LeonDV/SENA_monitoreo_fermentacion_cacao/README.md

# Termómetro de 3 sondas LoRa
Código para sensor de monitoreo del proceso de fermentación de cacao.
SENA AGROTURISTICO - SOCORRO

El repositorio incluye todos los archivos requeridos para la fabricación de un termómetro LoRa de 3 sondas con dos salidas de alarma. Los archivos para fabricación son los siguientes:

- Archivo de fabricación de circuito: 
  - **SENA_monitoreo_fermentacion_cacao/circuito/gerber/Gerber_PCB_SENA- TERMOMETRO_3_SONDAS_LORA.zip**
- Lista de materiales:
  - **SENA_monitoreo_fermentacion_cacao/circuito/lista_materiales/lista_materiales_ensamble.csv**
- Programación de Atmega328: 
  - **SENA_monitoreo_fermentacion_cacao/firmware_atmega_328/binarios_programacion_atmega/termometro_3_sondas_cacao.ino.eightanaloginputs.hex**
