LeonDV/SENA_monitoreo_fermentacion_cacao/circuito/lista_materiales/lista_materiales_ensamble.csv

ID | Name | Designator | Footprint | Quantity | Manufacturer Part | Manufacturer
1 | 100uF | C2,C1 | CAP-TH_BD5.0-P2.00-D0.8-FD | 2 | TY1071AMC115RB | Xunda
2 | SwitchSMD_daimob | OFF | SWITCHSMD | 1
3 | TS-1092D-B3D2 | RST | KEY-TH_2P-L6.0-W3.9-P6.50 | 1 | TS-1092D-B3D2 | Yuandi
4 | 10k | R7 | R_AXIAL-0.4 | 1
5 | HDR-F-2.54_1x4 | H1 | HDR-F-2.54_1X4 | 1
6 | WJ128V-5.0-2P | 5V5,ALARMA1,ALARMA2,BAT | CONN-TH_2P-P5.00_WJ128V-5.0-2P | 4 | WJ128V-5.0-2P | ReliaPro
7 | 22pF | C5,C6 | CAP-TH_L5.0-W2.5-P2.54-D0.7 | 2 | CC1H220JA1FDCH4B10MF | Dersonic
8 | HDR-M-2.54_1x3 | J2 | HDR-M-2.54_1X3 | 1
9 | AO3401A_C700954 | Q1,Q2,Q3 | SOT-23-3_L2.9-W1.3-P1.90-LS2.4-BR | 3 | AO3401A | HUASHUO(华朔)
10 | 100k | R1,R4,R5 | R_AXIAL-0.4 | 3
11 | 1k | R2,R3,R10,R11 | R_AXIAL-0.4 | 4
12 | 4.7k | R6,R8,R9 | R_AXIAL-0.4 | 3
13 | 1909763-1 | RF2 | ANT-SMD_1909763-1 | 1 | 1909763-1 | TE Connectivity
14 | EK508V-03P | SENS-1,SENS-2,SENS-3 | CONN-TH_EK508V-03P | 3 | EK508V-03P | Dinkle
15 | SX1276S8S+T-X1 | U1 | WIRELM-SMD_SX1278S165SY-T-X1 | 1 | SX1276S8S+T-X1 | Vollgo
16 | daimob-TP4056-modulo | U2 | DAIMOB-TP4056-MODULE-F | 1
17 | ATMEGA328P-PU | U3 | DIP-28_L34.6-W7.3-P2.54-LS10.2-BL | 1 | ATMEGA328P-PU | MICROCHIP
18 | MCP1826ST-3302E/DB | U4 | SOT-223_L6.5-W3.5-P2.30-LS7.0-BR | 1 | MCP1826ST-3302E/DB | MICROCHIP
19 | 16MHz | X1 | HC-49US_L11.5-W4.5-P4.88 | 1 | E49A16E00000DE10C0 | HOSONIC
20 | LED-TH-5mm_R | LED1 | LED-TH_BD5.0_RED | 1 | 333-2SURD/S530-A3 | EVERLIGHT(台湾亿光)
