LeonDV/SENA_monitoreo_fermentacion_cacao/circuito/esquema/SENA- TERMOMETRO_3_SONDAS_LORA.pdf

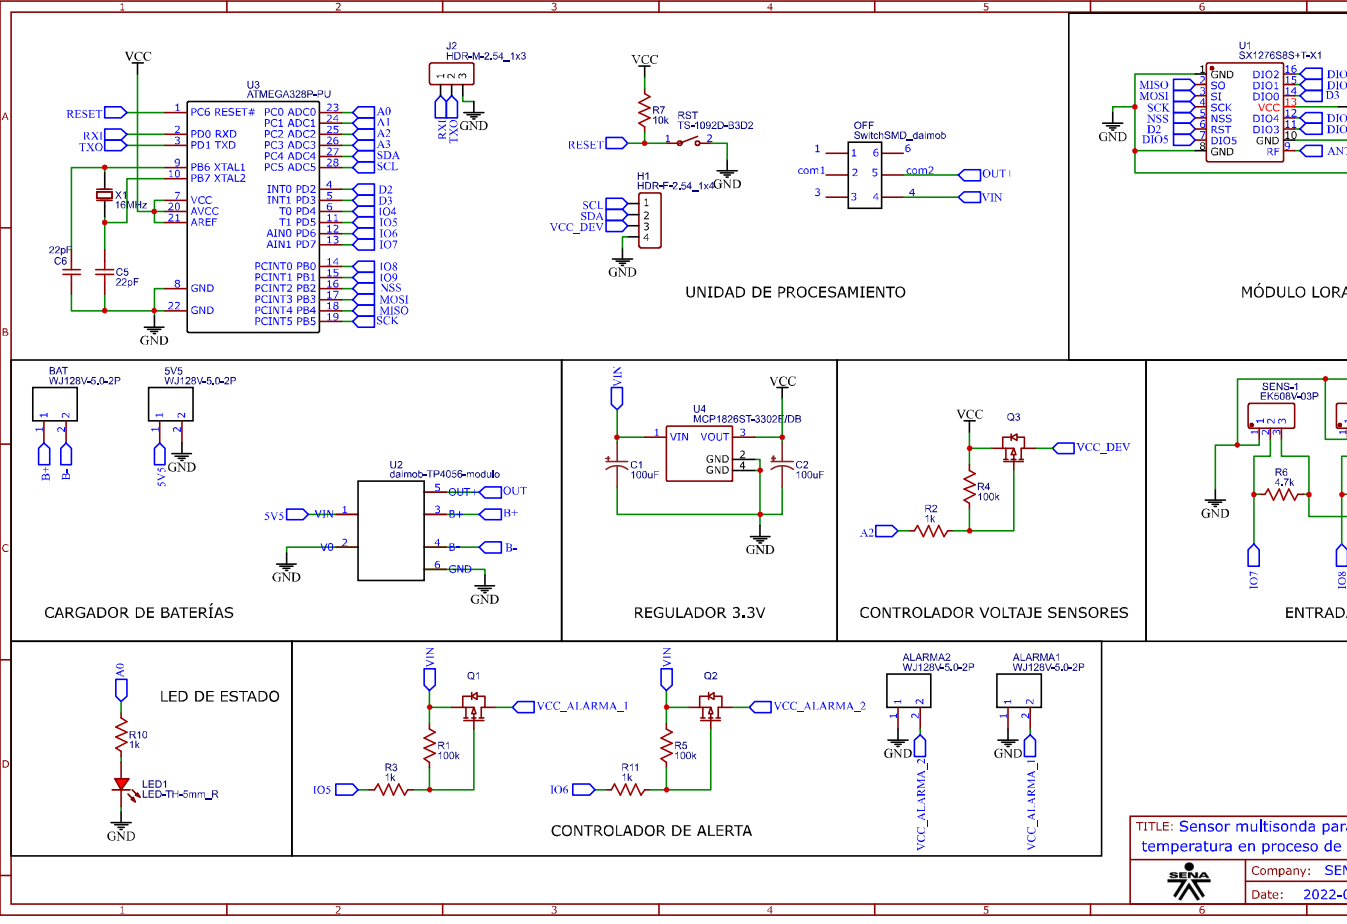
[picture p1: page 1]
