LeonDV/SENA_monitoreo_fermentacion_cacao/(commit log)

2022-05-22 Estructura inicial y declaración de variables
2022-06-03 Diseño de circuito
2022-06-18 Inicialización de variables
2022-12-20 Actualización de versión
